simonuks221/Iterptiniu_semestrinis_darbas/README.md

# Įterptinių semestrinis darbas
 
## Užduotis
Sukurti magnetinio kompaso įterptinę sistemą, iš magentometro ir akselerometro sensorių apskaičiuoti magentinės šiaurės kryptį, ją atvaizduoti vartotojui kompiuterio programos ir OLED ekrano pagalba.
Galimybė perkofigūruoti valdiklio siunčiamus duomenis neperkompiliuojant programos, įrašant iš kompiuterio gautas reikšmes į vidinę Flash atmintį.

## Vaizdai

Sujungtos schemos vaizdas:
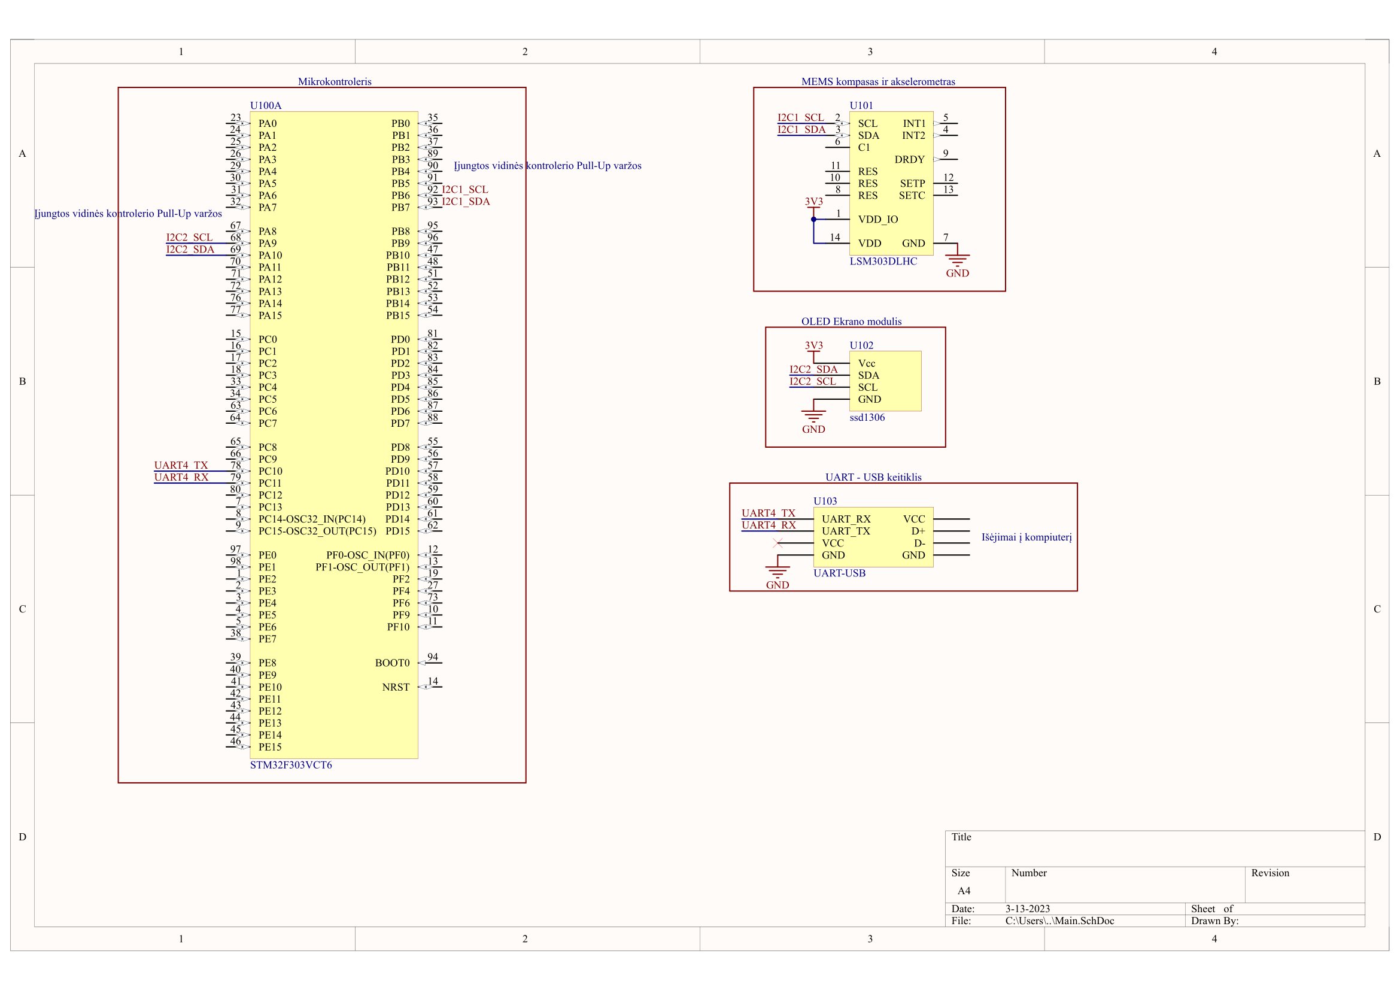
[picture p1: foto/Schema.jpg]

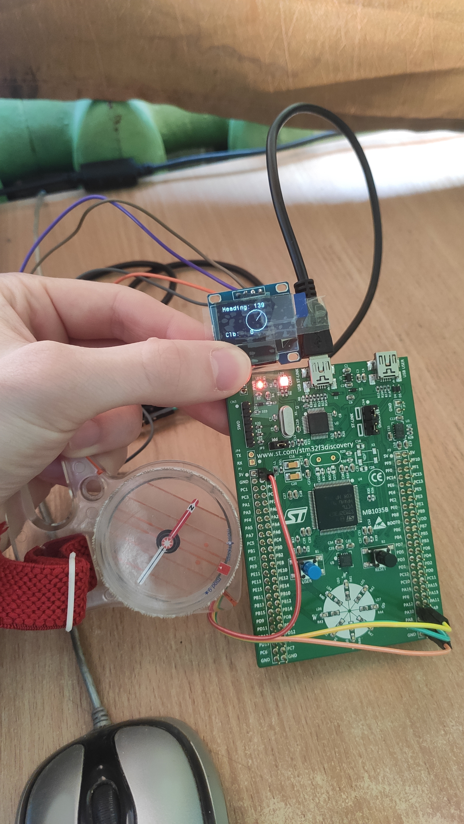
[picture p2: foto/IMG_20230326_172619.jpg]


Per UART-TTL keitiklį perduodami duomenys ir siunčiame perkofigūravimo inforamcija iš kompiuterio.
Kompiuterio programos vaizdas:
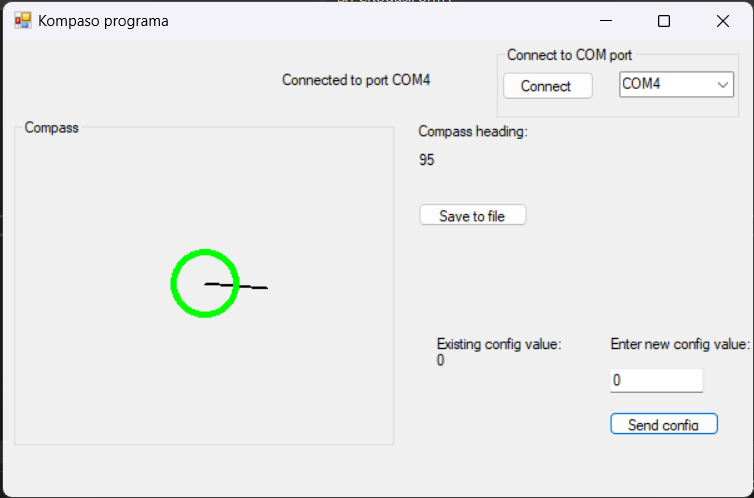
[picture p3: foto/Screenshot_2.png]
