simonuks221/Iterptiniu_semestrinis_darbas/foto/Bendra.drawio.png

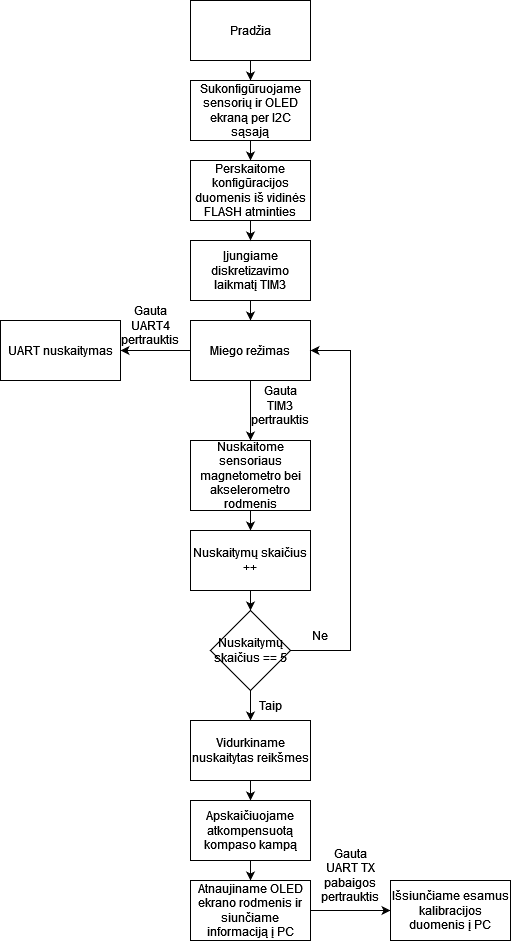
foto/Bendra.drawio.png
