simonuks221/Iterptiniu_semestrinis_darbas/foto/BLokine.drawio.png

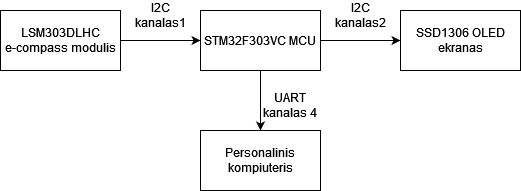
foto/BLokine.drawio.png
