simonuks221/Iterptiniu_semestrinis_darbas/foto/IMG_20230326_172702.jpg

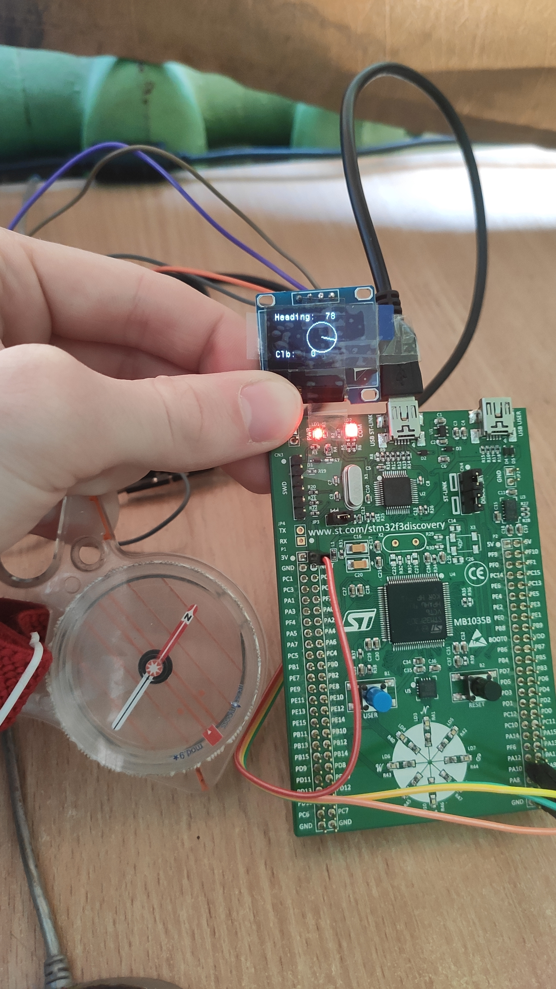
foto/IMG_20230326_172702.jpg
