simonuks221/Iterptiniu_semestrinis_darbas/foto/IMG_20230404_205336.jpg

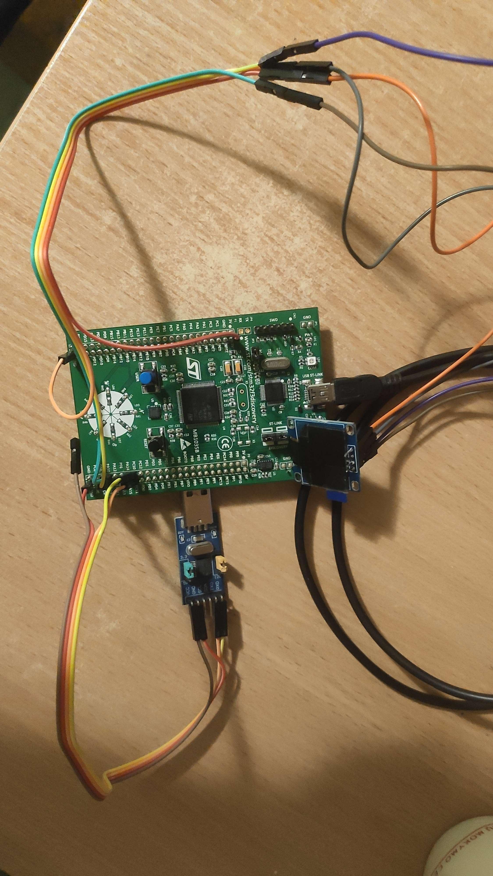
foto/IMG_20230404_205336.jpg
