simonuks221/Iterptiniu_semestrinis_darbas/foto/IMG_20230404_205350.jpg

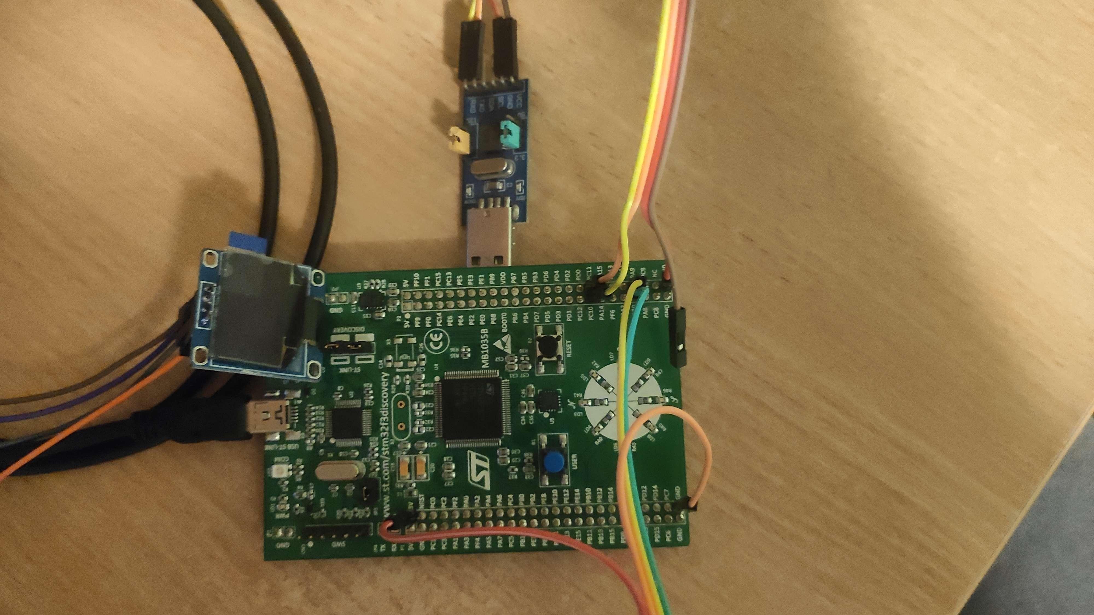
foto/IMG_20230404_205350.jpg
