simonuks221/Iterptiniu_semestrinis_darbas/foto/ProgramosAPrašas.drawio.png

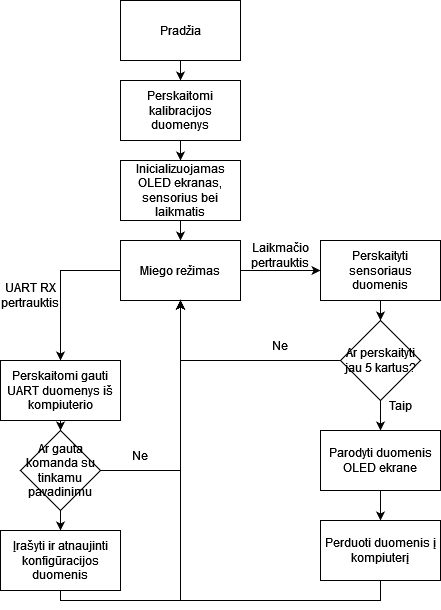
foto/ProgramosAPrašas.drawio.png
