simonuks221/Iterptiniu_semestrinis_darbas/foto/Screenshot_1.png

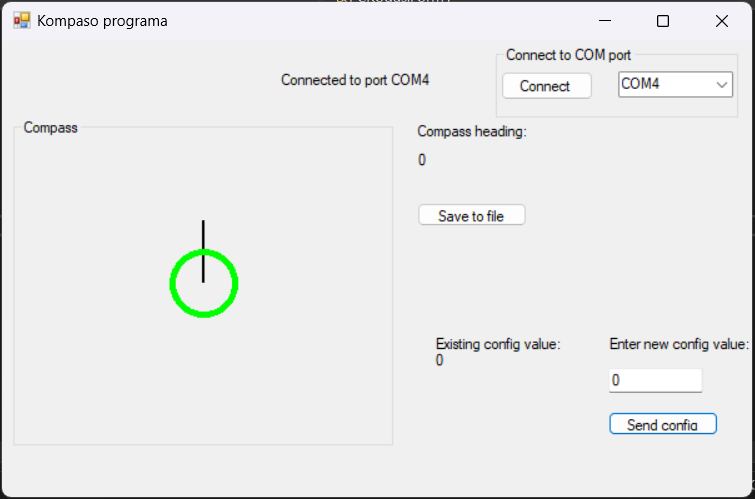
foto/Screenshot_1.png
