simonuks221/Iterptiniu_semestrinis_darbas/foto/Schema.pdf

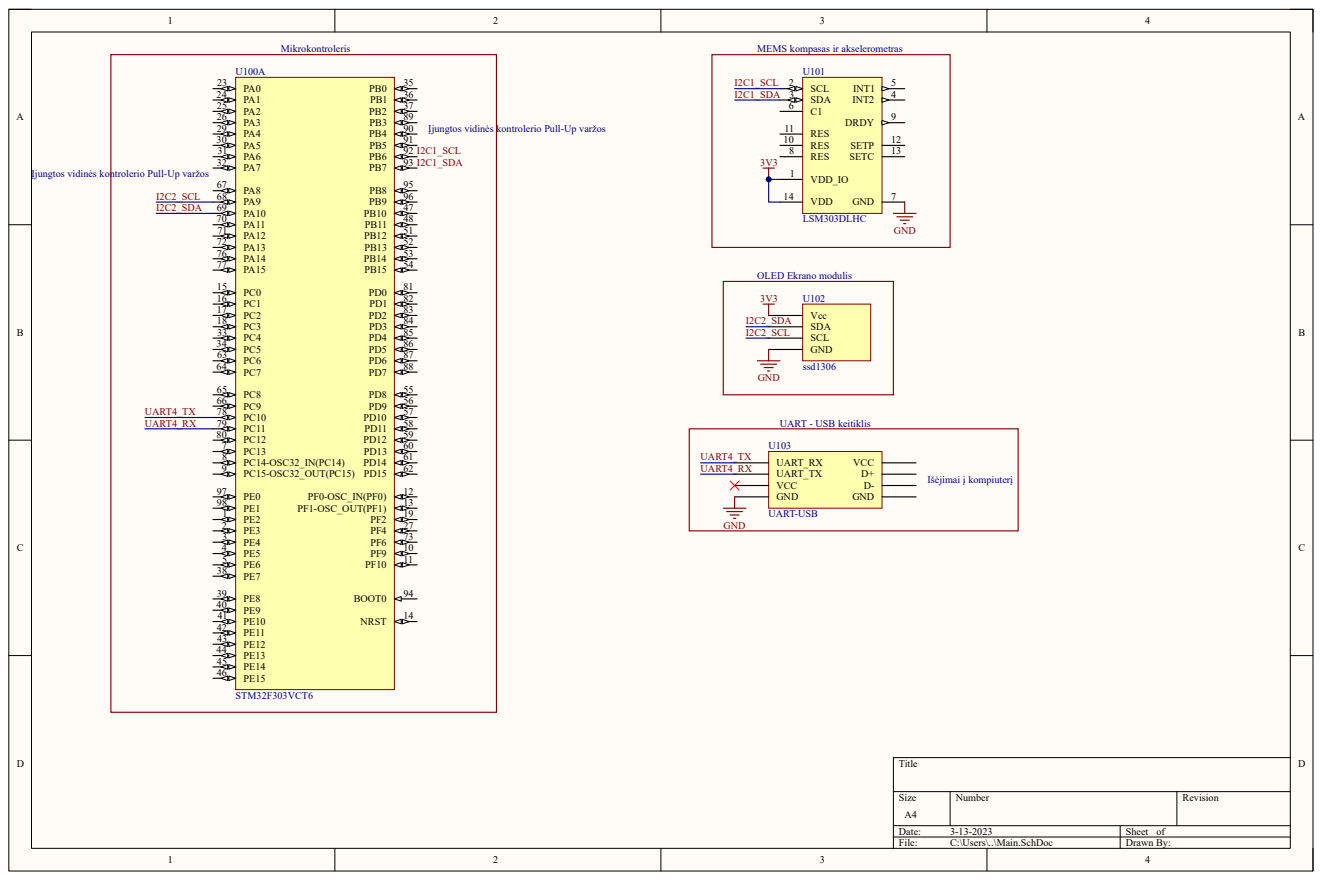
[picture p42: page 1]
Title; Size; Number; Revision; Date:; Sheet of; File:; C:\Users\..\Main.SchDoc; Drawn By:; PC15-OSC32_OUT(PC15) 9; PC14-OSC32_IN(PC14) 8; 19 PF1-OSC_OUT(PF1); PF0-OSC_IN(PF0); NRST; BOOT0; STM32F303VCT6; GND; SDA 3; DRDY; RES 8; INT1; VDD_IO 1; SCL 2; INT2; RES 10; RES 11; SETP; SETC; VDD 14; LSM303DLHC; Vcc SDA SCL GND; ssd1306; I2C1_SDA; I2C1_SCL; I2C1_SCL I2C1_SDA; I2C2_SDA; I2C2_SCL; Mikrokontroleris; UART_RX UART_TX VCC GND; VCC D+ D- GND; UART-USB; UART4_TX UART4_RX; Išėjimai į kompiuterį

MEMS kompasas ir akselerometras

Įjungtos vidinės kontrolerio Pull-Up varžos

OLED Ekrano modulis

UART - USB keitiklis
