simonuks221/Iterptiniu_semestrinis_darbas/(list of files, drawings)

Other design files:
Iterptiniu semestrinis/Iterptiniu semestrinis.PrjPcb
Iterptiniu semestrinis/Main.SchDoc
Iterptiniu semestrinis/Schlib1.SchLib
