simonuks221/Iterptiniu_semestrinis_darbas/Semestrinis.ioc

Mcu.UserName=STM32F303VCTx
PA0.GPIO_Label=B1 [Blue PushButton]
PA0.Signal=GPIO_Input
PA10.Signal=I2C2_SDA
PA11.GPIO_Label=DM
PA11.Signal=USB_DM
PA12.GPIO_Label=DP
PA12.Signal=USB_DP
PA13.GPIO_Label=SWDIO
PA13.Signal=SYS_JTMS-SWDIO
PA14.GPIO_Label=SWCLK
PA14.Signal=SYS_JTCK-SWCLK
PA9.Signal=I2C2_SCL
PB3.GPIO_Label=SWO
PB3.Signal=SYS_JTDO-TRACESWO
PB6.GPIO_Label=I2C1_SCL [LSM303DLHC_SCL]
PB6.Signal=I2C1_SCL
PB7.GPIO_Label=I2C1_SDA [LSM303DLHC_SDA]
PB7.Signal=I2C1_SDA
PC10.Signal=UART4_TX
PC11.Signal=UART4_RX
PC14-OSC32_IN.GPIO_Label=OSC32_IN
PC14-OSC32_IN.Signal=RCC_OSC32_IN
PC15-OSC32_OUT.GPIO_Label=OSC32_OUT
PC15-OSC32_OUT.Signal=RCC_OSC32_OUT
PE10.GPIO_Label=LD5 [Orange Led]
PE10.Signal=GPIO_Output
PE11.GPIO_Label=LD7 [Green Led]
PE11.Signal=GPIO_Output
PE12.GPIO_Label=LD9 [Blue Led]
PE12.Signal=GPIO_Output
PE13.GPIO_Label=LD10 [Red Led]
PE13.Signal=GPIO_Output
PE14.GPIO_Label=LD8 [Orange Led]
PE14.Signal=GPIO_Output
PE15.GPIO_Label=LD6 [Green Led]
PE15.Signal=GPIO_Output
PE8.GPIO_Label=LD4 [Blue Led]
PE8.Signal=GPIO_Output
PE9.GPIO_Label=LD3 [Red Led]
PE9.Signal=GPIO_Output
PF0-OSC_IN.GPIO_Label=OSC_IN
PF0-OSC_IN.Signal=RCC_OSC_IN
PF1-OSC_OUT.GPIO_Label=OSC_OUT
PF1-OSC_OUT.Signal=RCC_OSC_OUT
